tobiasfaust/WindowStatusSensor/ATMega328p Version/FHEM/README.md

Die Datei *HMConfig_AskSinPPCustom.pm* muss in das FHEM Verzeichnis (z.B. opt\fhem\FHEM) kopiert werden und FHEM neu gestartet werden.
