tobiasfaust/WindowStatusSensor/ATMega328p Version/Images/arduino-pro-mini-pinout.png

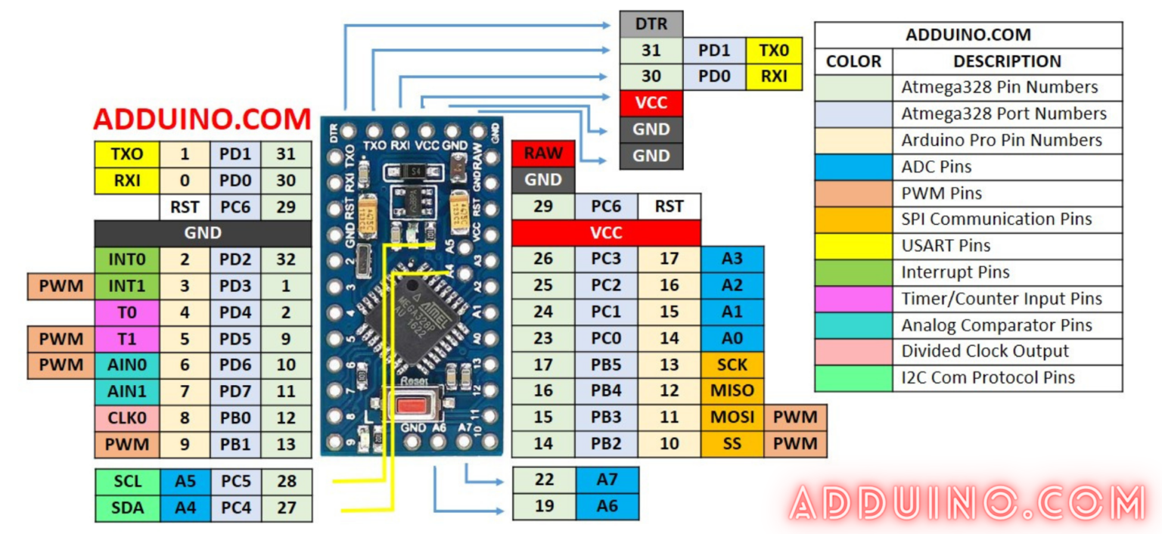
ATMega328p Version/Images/arduino-pro-mini-pinout.png
