tobiasfaust/WindowStatusSensor/ATMega328p Version/CircuitFiles/XGerber/Arduino_UP-Fensterkontakt_v2.1_BOM.xlsx

Comment | Designator | Footprint | JLCPCB Part #
LP2985 | IC2 | SOT23/5 | C95414
2,2µF | X1,X2 | 0805 | C5254797
100nF | C1 | 0805 | C49678
SUPPLY | K1 | ANSCHLUSSKLEMME-2_MINI
Reset | S1 | MICROSWITCH 5X5X1,5
LED Green | D2 | LED_3MM_GRÜN
1k | R3,R2 | 0805 | C17513
LED Red | D1 | LED_3MM_GRÜN
CNT1 | K2 | ANSCHLUSSKLEMME-2_MINI
CNT2 | K3 | ANSCHLUSSKLEMME-2_MINI
CNT3 | K4 | ANSCHLUSSKLEMME-2_MINI
CNT4 | K5 | ANSCHLUSSKLEMME-2_MINI
CNT5 | K6 | ANSCHLUSSKLEMME-2_MINI
CNT6 | K7 | ANSCHLUSSKLEMME-2_MINI
CNT8 | K8 | ANSCHLUSSKLEMME-2_MINI
CNT7 | K9 | ANSCHLUSSKLEMME-2_MINI
Stiftleiste_1x02_G_2,54 | J2 | Stiftleiste_1x02_G_2,54
Arduino_Mini Pro | X11 | Arduino Mini Pro
CC1101_BreakoutModule_868MHZ | X12 | CC1101_Module_868MHZ_SMD_RM2.54
Config | S2 | MICROSWITCH 5X5X1,5 | C410374
ISP | K10 | WANNENSTECKER-06-ST
