tobiasfaust/WindowStatusSensor/NRG Version/Images/serial_wiring.jpg

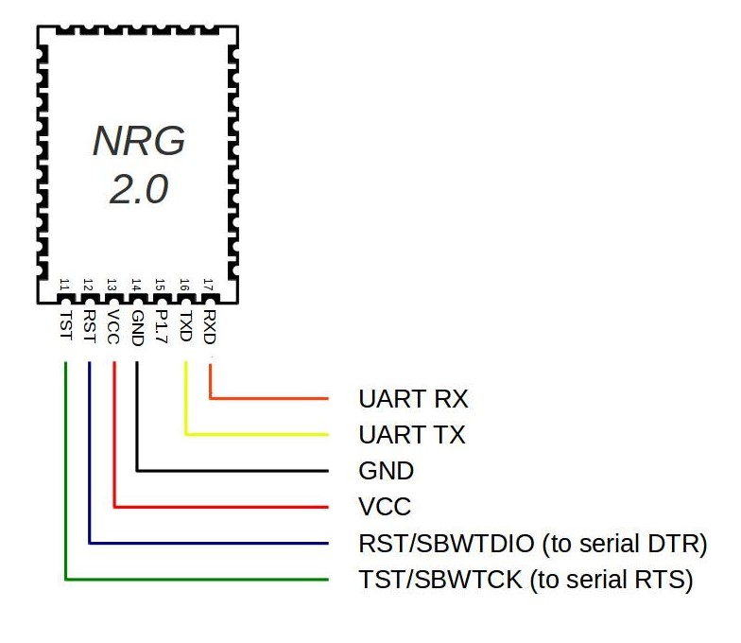
NRG Version/Images/serial_wiring.jpg
