tobiasfaust/WindowStatusSensor/ATMega328p Version/CircuitFiles/Arduino_UP-Fensterkontakt_v2.1_PCB.PDF

49,85

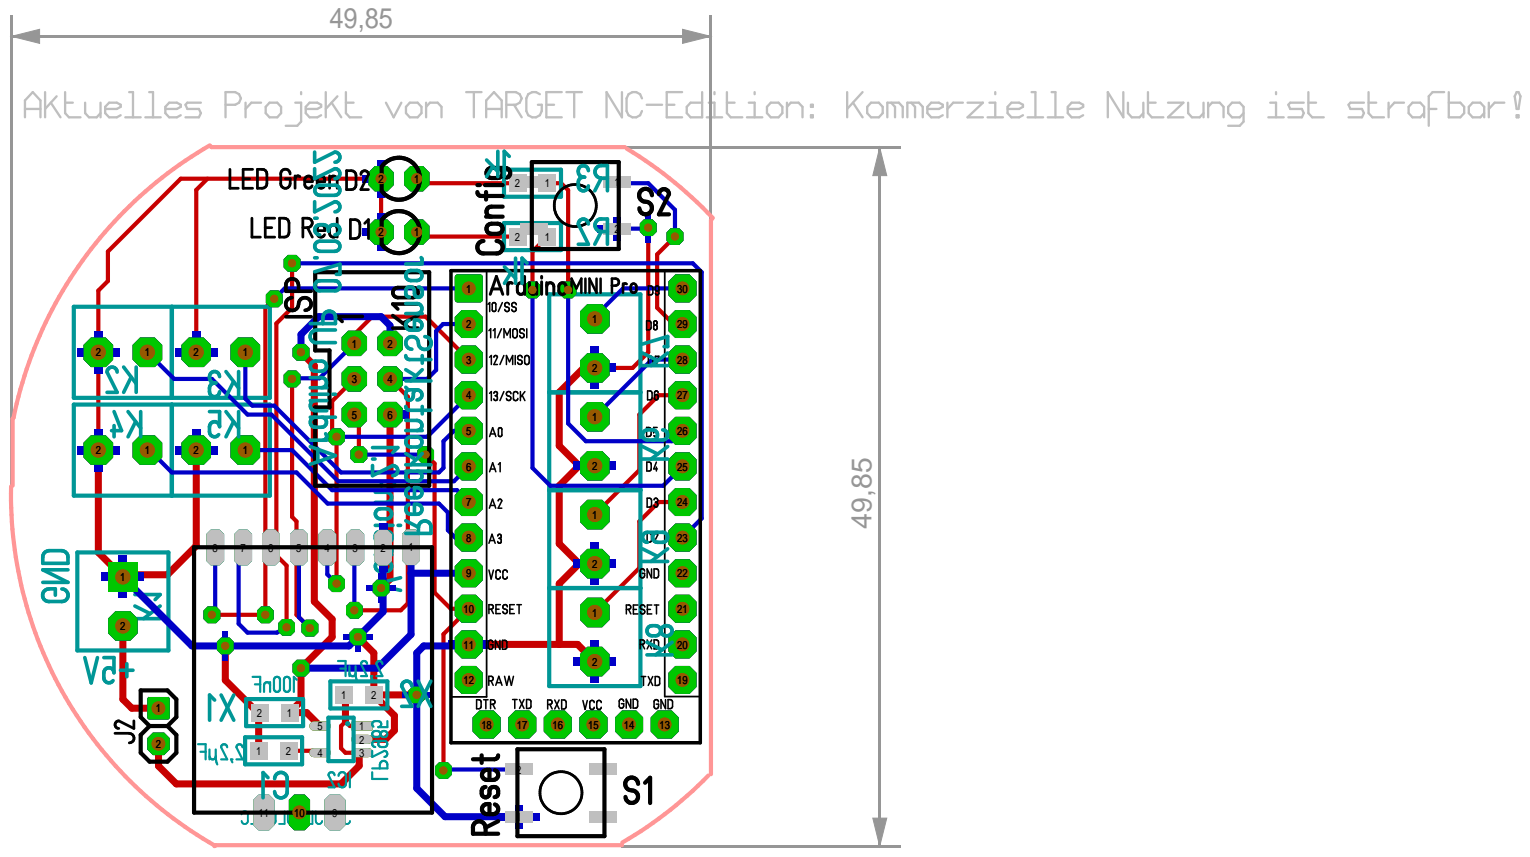
[picture p14: page 1]
