tobiasfaust/WindowStatusSensor/ATMega328p Version/CircuitFiles/Arduino_UP-Fensterkontakt_v2.1_SCH.PDF

## CNT7

## CNT8

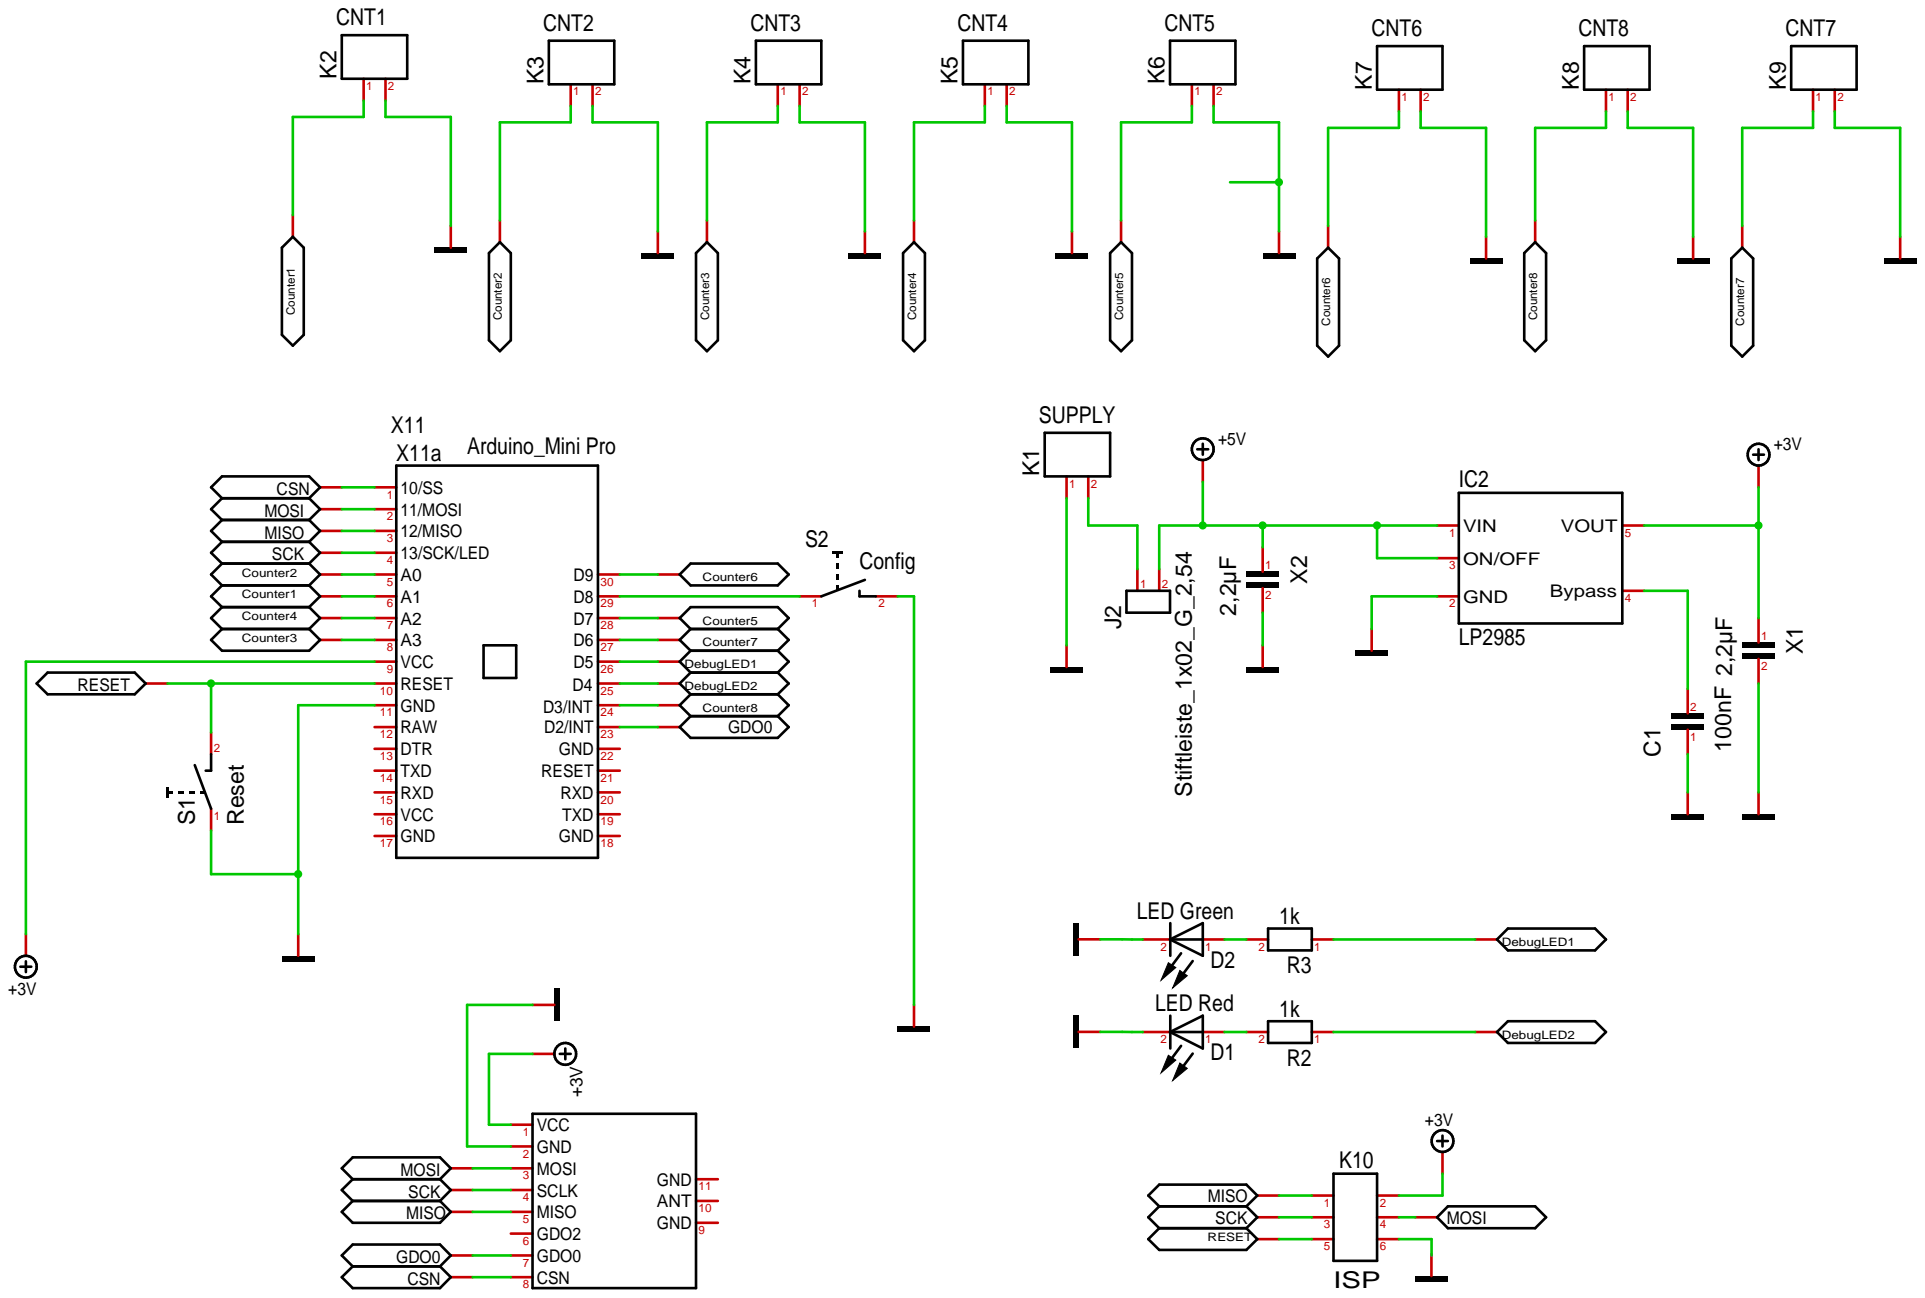
[picture p15: page 1]
