tobiasfaust/WindowStatusSensor/(commit log)

2018-08-24 Create CircuitFiles
2025-09-13 added BOM + CPL file for SMD parts to order at JLCPCB.com
    [Arduino_UP-Fensterkontakt_v2.1_BOM.xlsx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]
2025-09-16 JLCJLCJLCJLC moved
    [Arduino_UP-Fensterkontakt_v2.1_BOM.xlsx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]
